edgaralejod/fpga-edge-npu/(commit log)

2026-11-04 Phase 1: PCIe link between the AC701 and the FRDM-i.MX95
    XDMA endpoint at Gen2 x1 with the npu_regs control block on BAR0 and 64 KiB
    of card memory on the DMA path, built from Tcl and booted from SPI flash.
    On hardware the card enumerates, register reads take 1.18 us, DMA moves
    64 KiB at about 290 MB/s each way and the user interrupt reaches the driver.
    Card-to-host DMA needs the i.MX95 IOMMU in pass-through; bringup.md has the
    details and the problems found.
    [ac701.xdc, npu_regs.v, npu_top.v, tb_npu_regs.v]
2026-11-04 Phase 2: DDR3 card memory with debug cores
    Card memory is now the AC701's 1 GiB DDR3 SODIMM behind the MIG, in a block
    design rebuilt from hw/bd/card_mem.tcl. SmartConnect shares it with a
    JTAG-to-AXI master; System ILAs with AXI protocol checkers watch both sides,
    and a VIO on the Si570 user clock reports calibration and resets the MIG.
    npu_regs 0.2.0 adds DDR status and DMA counters. On hardware the DDR3
    calibrates, jtag-memtest and a 1 GiB memtest from the i.MX95 pass, and DMA
    reaches 371 MB/s to the card and 325 MB/s back. Card-side bandwidth is still
    open. Also: make project for a Vivado GUI project, and a systemd unit that
    loads the driver at boot on the i.MX95.
    [ac701.xdc, axi_dma_mon.v, npu_regs.v, npu_top.v, tb_npu_regs.v]
2026-11-04 Docs: bench photo and a System ILA capture
    The photo of the FRDM-i.MX95 and AC701 opens the README and illustrates the hardware setup; GPS and other metadata were stripped. The Hardware Manager capture of the MIG-side ILA shows DDR3 reads with OKAY responses and a clean protocol checker, in the README and the debugging guide. The setup page now records the riser and power arrangement as checked on hardware.
2026-11-04 Phase 2 done: card-side DDR3 bandwidth, and a fix for AMD's XDMA driver
    mem_bw, a 512-bit AXI4 master beside the MIG, writes and reads card memory
    in 4 KiB bursts, checks every beat and times itself: 5468 MB/s write and
    5921 MB/s read over 1 GiB, 85 and 93 % of the DDR3 peak. Its handshakes
    were checked against AMD's AXI4 master template, which caught write data
    waiting for AWREADY; tb_mem_bw now has a slave that deadlocks on that.
    npu_regs 0.3.0 adds the BW_* registers.
    The stale-page DMA corruption on the i.MX95 was AMD's XDMA driver unmapping
    with the IOMMU-merged entry count, so only the first page's cache lines
    were invalidated (upstream issue #386). sw/patches has the fix; the IOMMU
    n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
    [ac701.xdc, mem_bw.v, npu_regs.v, npu_top.v, tb_mem_bw.v, tb_npu_regs.v]
2026-11-04 Phase 3 design: command queue, completion ring, own driver
    docs/command-queue.md fixes the contract between the card's queue engine and the fpga-npu driver: XDMA replaced by the axi_pcie bridge so the card can fetch commands and write completions in host memory, 64-byte commands, 16-byte completions with an NVMe-style phase bit, doorbells and registers, and the acceptance tests. Nothing is built yet.
2026-11-04 Site: an interactive explainer of the system, for Firebase Hosting
    site/public is a one-page site with no build step: a block diagram from the i.MX95's CPU through the IOMMU and PCIe link into the card's DDR3, where each block shows what it does, its measured numbers and what went wrong there; four animated data flows with the bench's timings and deep links; three charts with tooltips and table views; the ILA capture and the three bugs. Every number lives in data.js, labelled measured, derived or spec. Also corrects a stale line in docs/edge-ai-accelerators.md.
2026-11-04 Phase 3: npu_cq command queue engine, simulated
    npu_cq fetches 64-byte commands from a ring in host memory, runs NOP, COPY_H2C and COPY_C2H, writes 16-byte completions with a phase bit and card timestamps, stalls on a full completion ring and requests MSIs. Copies stream through a FIFO with up to four 2 KiB reads in flight. tb_npu_cq drives it as the driver will, against a new AXI memory model with stalls, latency and slaves that wait for write data, and passes; a phase-bit mutant fails it. Not in the bitstream yet.
    [axi_mem_model.v, fifo_fwft.v, npu_cq.v, tb_npu_cq.v]
2026-11-04 Phase 3: axi_pcie bridge, npu_cq and npu_mm in the design; driver, runtime, MNIST
    The card_sys block design (renamed from card_mem) replaces XDMA with AMD's
    axi_pcie bridge (PG055): device 10ee:ed10, BAR0 to npu_regs through an
    AXI4-Lite converter, a slave window through which npu_cq reaches host
    memory, MSI, and PERST# through proc_sys_reset as PG055 describes.
    npu_regs 0.4.0 adds the command queue registers. npu_mm is pipelined to
    nine stages and its buffers made RAM-friendly after the first build missed
    timing by 4.2 ns. sw/driver is a small GPL-2.0 kernel driver (DMA arena,
    BAR0, MSI), sw/npu the user-space runtime with npu-test and npu-mnist, and
    sw/mnist/train.py trains and quantizes t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
    [ac701.xdc, axi_dma_mon.v]
2026-11-04 Fix GEMM writes for N = 1024, register the mover's requests, keep command IDs on a full SQ
    The write side took its sizes from N's low 10 bits, so N = 1024 wrote
    nothing; the testbench now runs K = 2048, N = 1024 and fails without the
    fix. The mover's read requests are decided from registers (timing at
    125 MHz). npu-mnist prints one inference as a trace. fpga-npu.service
    loads the driver at boot.
    [npu_cq.v, npu_mm.v, tb_npu_cq.v]
2026-11-04 0.5.0: GEMM in tiles of 8 rows; phases 3 and 4 measured on the card
    npu_mm holds 8 rows of A, so each weight beat feeds 64 MACs: 6.5 GMAC/s
    on the card (0.87 before), MNIST at 55 000 images/s, 97.11 %, bit-exact,
    4 times one Cortex-A55 core. Bring-up records the queue, copies, GEMMs
    and MNIST on 0.4.0 and 0.5.0, the problems found, and the raw logs in
    docs/results/. npu-test's CPU reference now uses cached memory.
    [npu_mm.v, npu_regs.v, tb_npu_cq.v, tb_npu_regs.v]
